gregoryvanko/SemX/STL/assemblage_v13_vue.stl

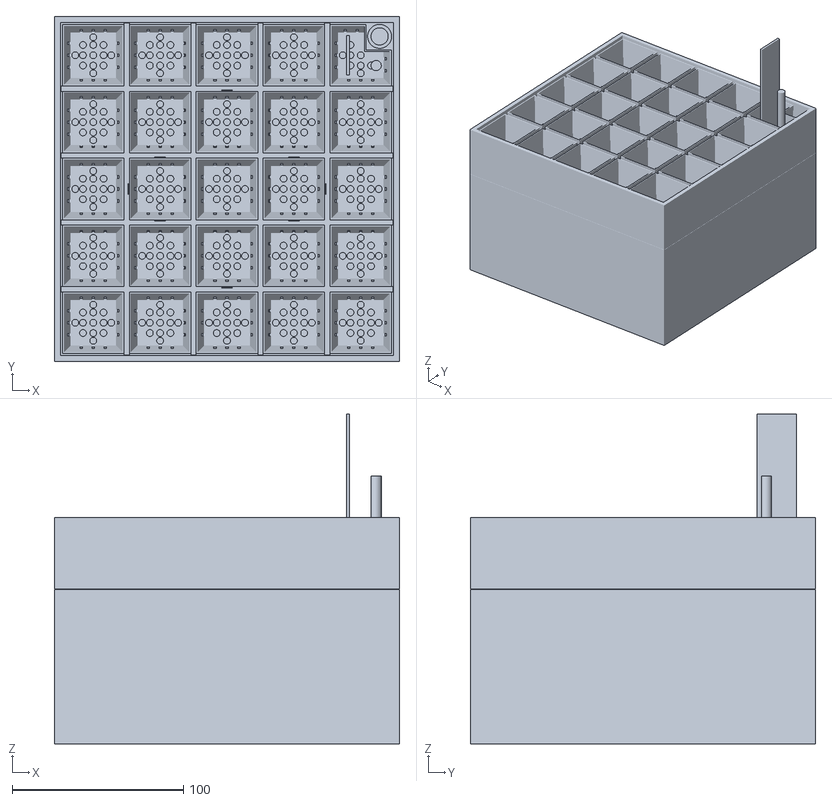
[picture p19: CAD file, 2026-11-14]
STL/assemblage_v13_vue.stl
201.2 x 201.2 x 192.2
