gregoryvanko/SemX/STL/assemblage_v13_eclate_vue.stl

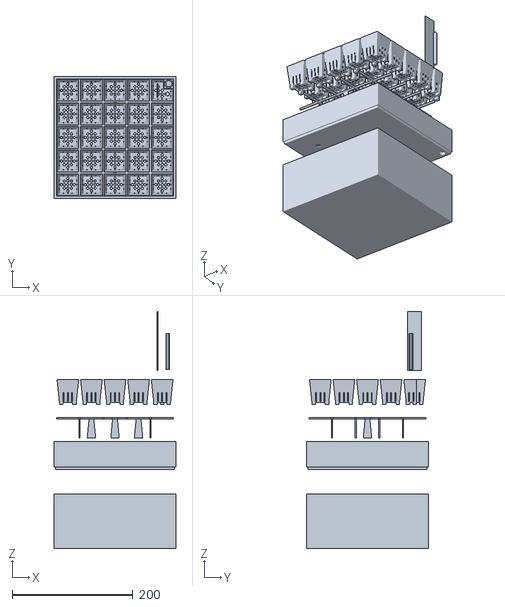
[picture p20: CAD file, 2026-11-14]
STL/assemblage_v13_eclate_vue.stl
201.2 x 201.2 x 392.2
