gregoryvanko/SemX/STL/assemblage_support_led_vue.stl

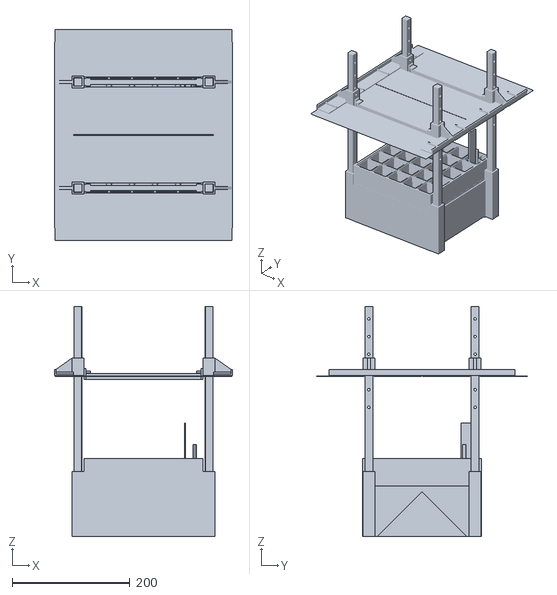
[picture p21: CAD file, 2026-11-14]
STL/assemblage_support_led_vue.stl
302.0 x 357.1 x 390.0
