gregoryvanko/SemX/STL/grille_godets_pieds_193x193x2.stl

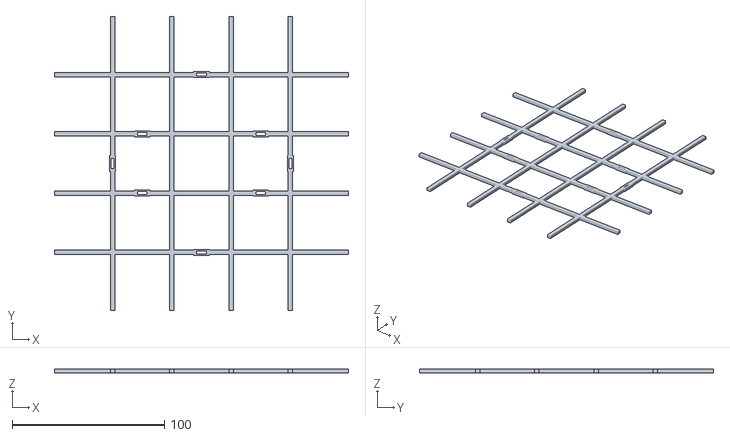
[picture p22: CAD file, 2026-11-14]
STL/grille_godets_pieds_193x193x2.stl
193.4 x 193.4 x 2.40
