gregoryvanko/SemX/STL/godet_mesure_L_36x36x42.stl

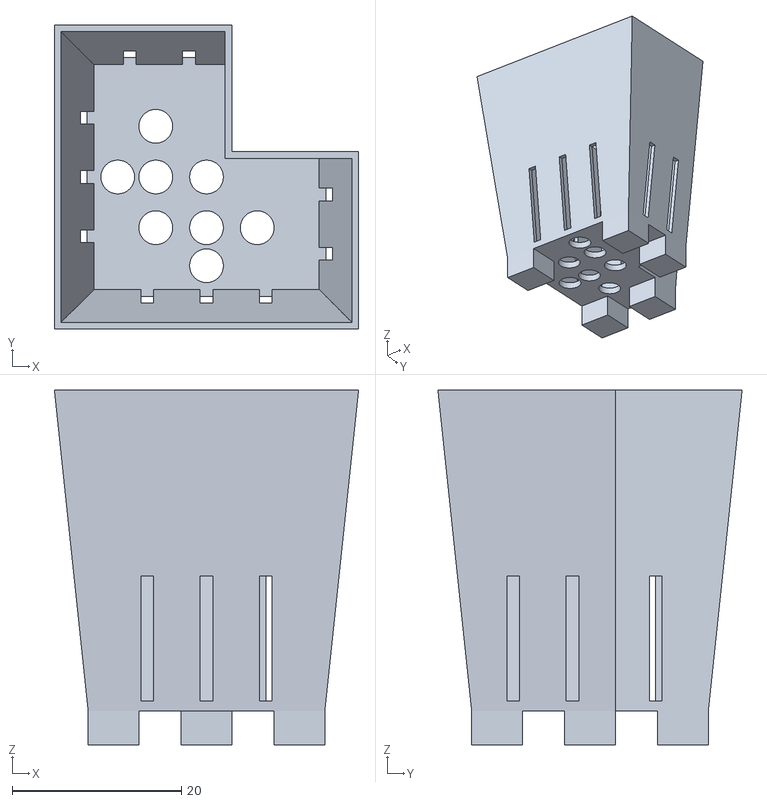
[picture p23: CAD file, 2026-11-14]
STL/godet_mesure_L_36x36x42.stl
36.0 x 36.0 x 42.0
