gregoryvanko/SemX/STL/Electronique couvercle.stl

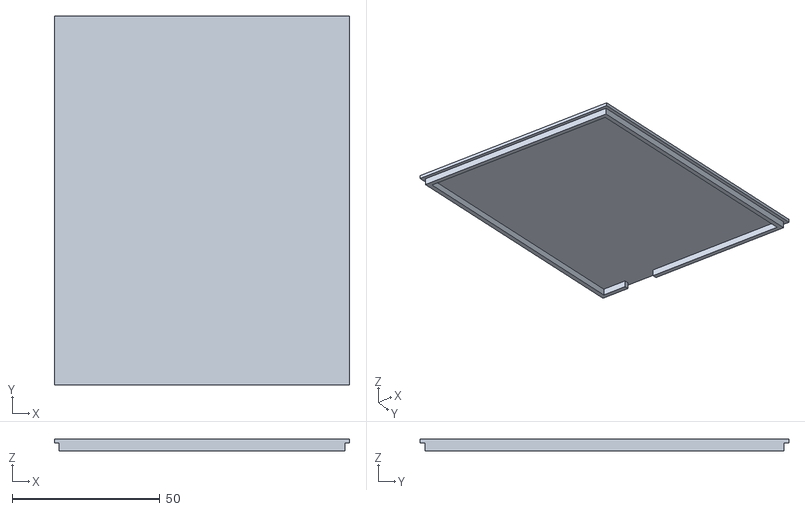
[picture p24: CAD file, 2026-11-09]
STL/Electronique couvercle.stl
100.0 x 125.0 x 4.20
