gregoryvanko/SemX/STL/Electronique boitier.stl

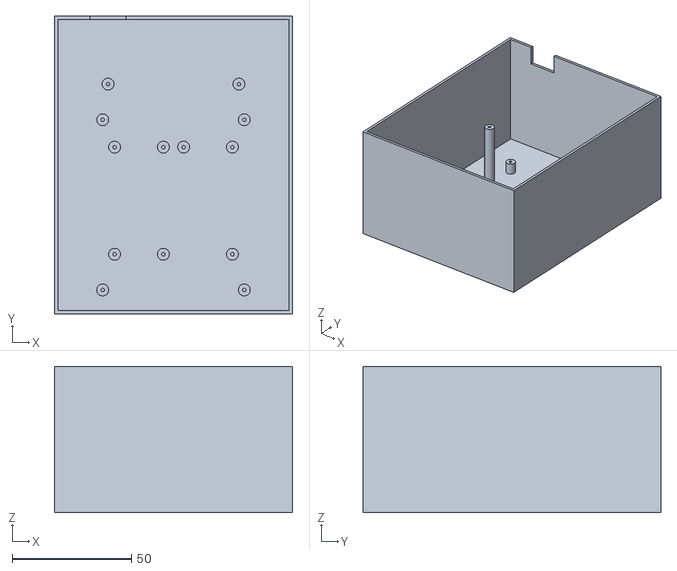
[picture p25: CAD file, 2026-11-09]
STL/Electronique boitier.stl
100.0 x 125.0 x 61.4
