gregoryvanko/SemX/STL/grille_godets_pied_14x33.stl

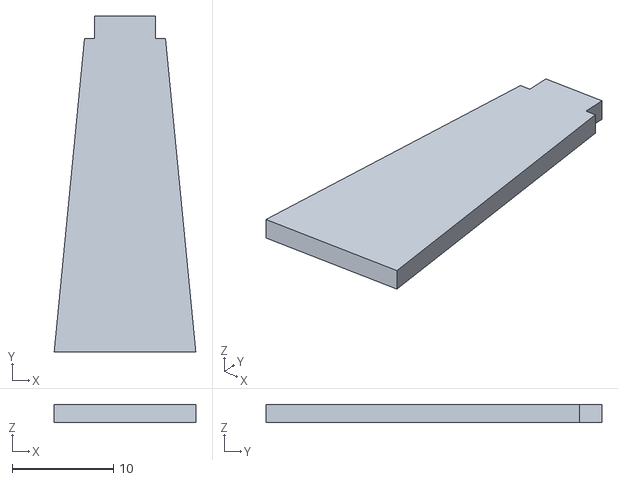
[picture p26: CAD file, 2026-11-08]
STL/grille_godets_pied_14x33.stl
14.0 x 33.2 x 1.80
