gregoryvanko/SemX/STL/support_led_entretoise.stl

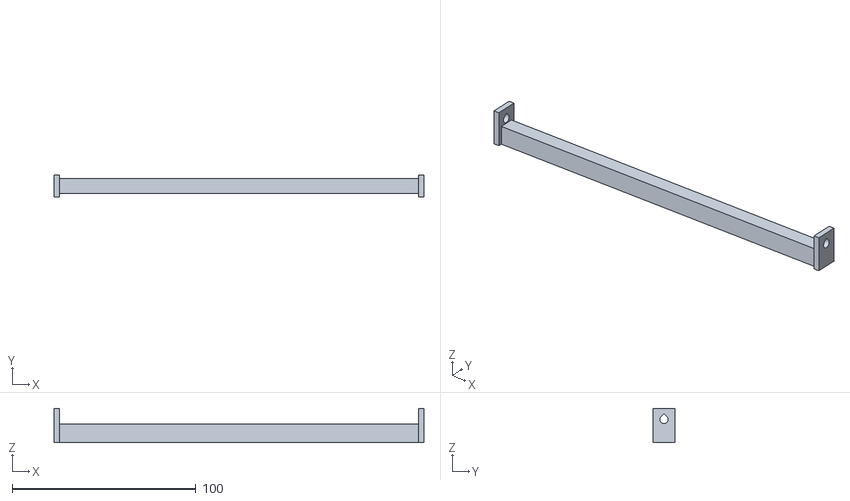
[picture p27: CAD file, 2026-11-05]
STL/support_led_entretoise.stl
201.4 x 12.0 x 18.6
