gregoryvanko/SemX/STL/support_led_traverse.stl

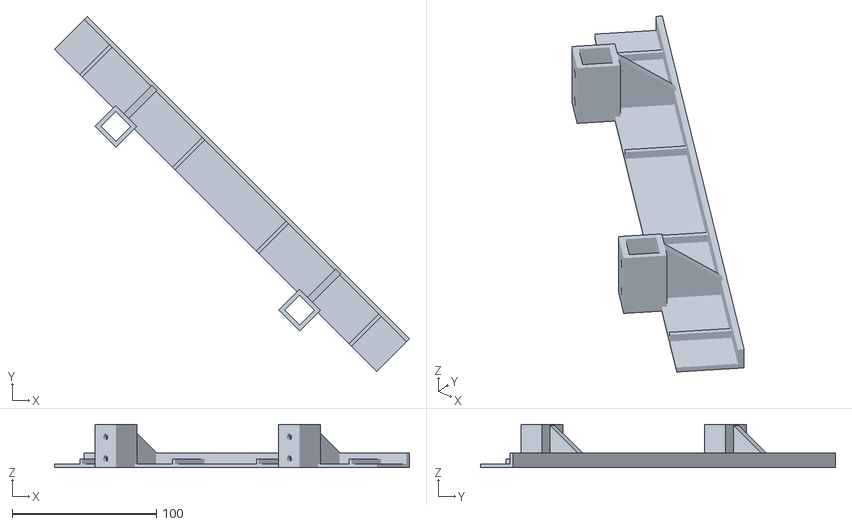
[picture p28: CAD file, 2026-11-01]
STL/support_led_traverse.stl
246.1 x 246.1 x 30.0
