gregoryvanko/SemX/STL/support_led_pied.stl

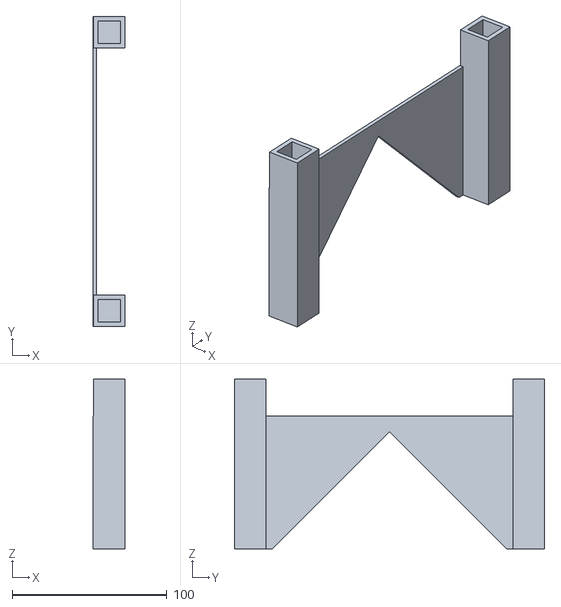
[picture p29: CAD file, 2026-11-01]
STL/support_led_pied.stl
20.9 x 200.6 x 110.0
