gregoryvanko/SemX/STL/support_led_goupille.stl

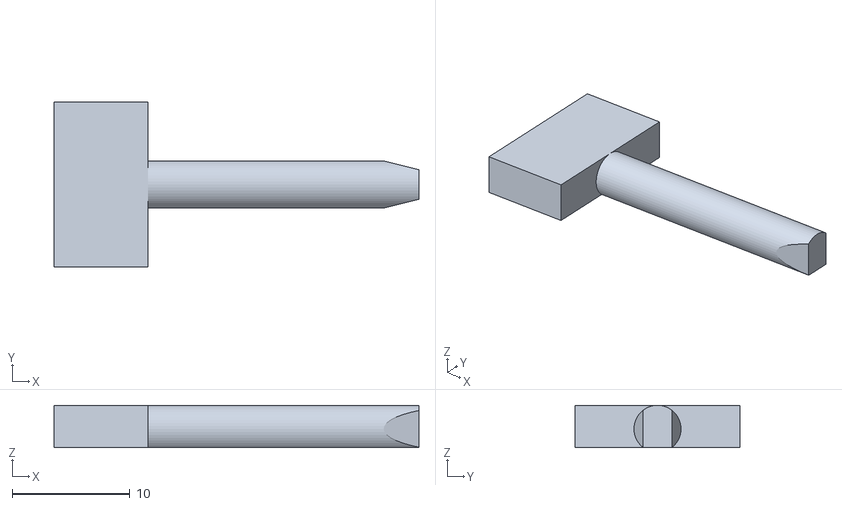
[picture p30: CAD file, 2026-11-01]
STL/support_led_goupille.stl
31.0 x 14.0 x 3.60
