gregoryvanko/SemX/STL/support_led_colonne.stl

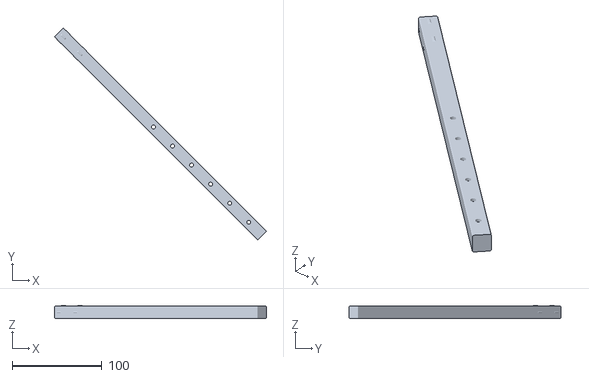
[picture p31: CAD file, 2026-11-01]
STL/support_led_colonne.stl
236.2 x 236.2 x 14.6
