gregoryvanko/SemX/STL/Tuyau Pompe.stl

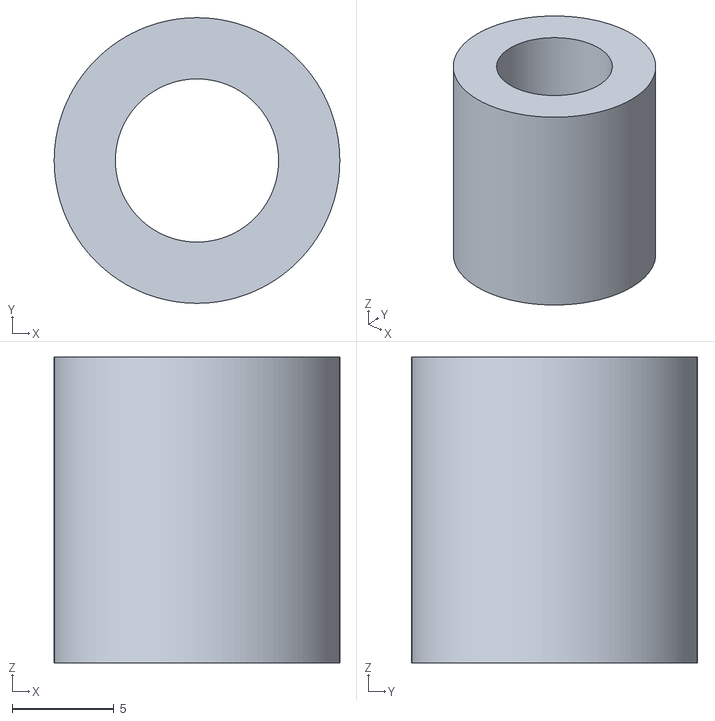
[picture p32: CAD file, 2026-10-24]
STL/Tuyau Pompe.stl
14.0 x 14.0 x 15.0
