gregoryvanko/SemX/STL/reservoir_201x201x90_2piliers_paroi2.0.stl

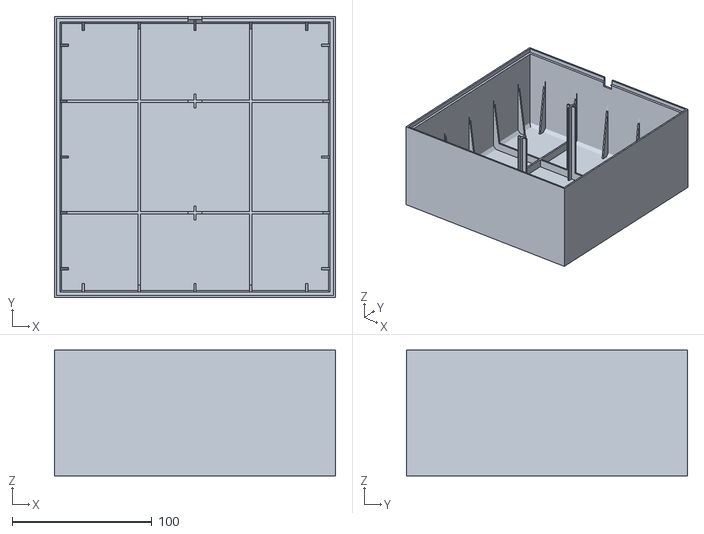
[picture p33: CAD file, 2026-10-24]
STL/reservoir_201x201x90_2piliers_paroi2.0.stl
201.2 x 201.2 x 90.0
