gregoryvanko/SemX/STL/bac_semis_201x201x46_socle.stl

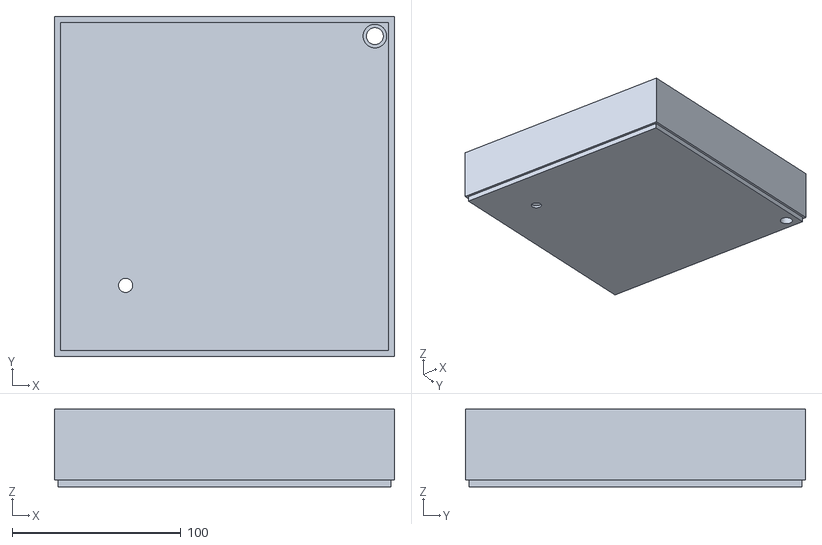
[picture p34: CAD file, 2026-10-24]
STL/bac_semis_201x201x46_socle.stl
201.2 x 201.2 x 46.0
