gregoryvanko/SemX/(list of files, cad)

Other CAD files:
STL/godet_semis_36x36x42.stl
