gregoryvanko/SemX/(commit log)

2026-10-14 README : ajout des éléments techniques (ESP32, capteurs, relais)
2026-10-14 README : ajout du tableau de brochage de l'ESP32
2026-10-23 Ajout de la librairie ESPConnect
    Portail captif WiFi, stockage NVS, reconnexion automatique, bouton de
    réinitialisation, page /status avec configuration MQTT à chaud
    (mqtt/mqtts/ws/wss, TLS sans vérification), statut online/LWT, routes
    web personnalisées et WebSocket. Exemple d'utilisation dans main.cpp.
2026-10-23 ESPConnect : lecture NVS sans erreur pour les clés absentes
    Preferences::getString() journalise « nvs_get_str len fail » quand la
    clé n'existe pas encore ; on vérifie sa présence avec isKey() avant
    de la lire.
2026-10-23 ESPConnect : journal série en ASCII
    Les caractères UTF-8 multi-octets (accents, « », —, …) s'affichaient
    en "???????" dans le moniteur série. Les messages sont désormais
    convertis en ASCII avant l'écriture.
2026-10-23 Exemple : suppression de la publication MQTT semix/uptime
    Seul l'envoi WebSocket de démonstration vers /semis est conservé.
2026-10-23 ESPConnect : mise à jour du firmware par le réseau (OTA)
    enableOTA(motDePasse, port) active ArduinoOTA dès la connexion WiFi.
    MQTT et WebSockets sont fermés proprement au début du téléversement,
    MQTT est relancé en cas d'échec. État OTA affiché sur /status,
    progression et erreurs dans le journal série.
2026-10-23 initiation du setup de l'application
2026-10-24 nouveau couvercle godet
    [couvercle_godet_mesure_36x19.stl]
2026-10-25 update couvercle
    [couvercle_godet_mesure_36x19.stl]
2026-10-27 page de commande web SemW
2026-10-31 relay controleur default value
2026-10-31 support de godet mesure
    [support_godet_mesure_36x19.stl]
2026-11-01 support panneaux led
    [assemblage_support_led_vue.stl, support_led_colonne.stl, support_led_goupille.stl, support_led_pied.stl, support_led_traverse.stl]
2026-11-01 support LED à quatre colonnes et rendus 3D
    Remplace les deux colonnes par quatre colonnes de 14 mm pour que chaque
    face forme un portique et résiste à la torsion. Un pied à deux fûts par
    face garantit l'écartement des colonnes, et une traverse à deux
    coulisseaux porte les panneaux, dont les deux centraux sont maintenant
    jointifs au-dessus du bac.
    Ajoute le script de rendu et les images 3D intégrées au README.
    [assemblage_support_led_vue.stl, support_led_colonne.stl, support_led_goupille.stl, support_led_pied.stl, support_led_traverse.stl]
2026-11-01 traverses collées, entretoises et nervures de colonne
    Les panneaux de 1 mm sont maintenant collés sous les traverses par leur
    face arrière, avec huit adhésifs 3M de 30 × 50 mm posés sur des plages
    planes. Les poches sont supprimées et le dessous des panneaux reste libre
    pour les fiches USB-C. Les trous du coulisseau sont décalés pour garder
    la marge au-dessus du capteur d'humidité.
    Ajoute deux entretoises fixées par les goupilles, rallongées de 3 mm, et
    des nervures d'écrasement en bas de colonne pour supprimer le jeu dans le
    pied, avec une pièce de test pour régler le serrage.
    [assemblage_support_led_vue.stl, support_led_colonne.stl, support_led_entretoise.stl, support_led_goupille.stl, support_led_test_nervures.stl, support_led_traverse.stl]
2026-11-01 retire la pièce de test des nervures
    Le serrage de 0,1 mm est validé sur une pièce imprimée : la pièce de test
    n'est plus utile. La colonne reste inchangée.
    [support_led_test_nervures.stl]
2026-11-01 ramène les pieds dans la largeur du réservoir
    Le pied dépassait de 2,2 mm de chaque côté. Il fait maintenant 200,6 mm
    pour un réservoir de 201,2 mm : l'entraxe des colonnes passe à 180,1 mm
    et les panneaux sont resserrés d'autant, seule la colonne passant entre
    eux. Pied et traverse changent, les autres pièces restent identiques.
    [assemblage_support_led_vue.stl, support_led_pied.stl, support_led_traverse.stl]
2026-11-01 rigidifie les traverses avec une bande de collage continue
    Remplace les quatre plages séparées par une bande de 32 mm sur toute la
    longueur, qui forme une cornière avec la paroi. La section la plus faible
    devient 2,3 fois plus rigide en flexion verticale pour 4 g de plus par
    traverse. Les autres pièces restent identiques.
    [assemblage_support_led_vue.stl, support_led_traverse.stl]
2026-11-05 entretoise à un seul trou, plus basse, réglage par crans de 30 mm
    [assemblage_support_led_vue.stl, support_led_entretoise.stl]
2026-11-05 entretoise suspendue sous la goupille, entre les panneaux
    [assemblage_support_led_vue.stl, support_led_entretoise.stl]
2026-11-06 PCB de l'ESP32 à graver à la CNC et description des pièces du bac
    Ajoute un circuit simple face pour l'ESP32 DevKit C V4, les sondes, les
    relais et le bornier 5 V, avec une diode qui permet de garder l'USB branché.
    Le script PCB/pcb_semix.py génère Gerber, perçage et G-code GRBL.
    Ajoute au README les rendus et la description du réservoir, du bac, des
    godets et de leurs accessoires, générés par CAD/rendu_pieces.py.
    [SemiX-B_Cu.gbl, SemiX-Edge_Cuts.gm1, SemiX.drl]
2026-11-07 relais led
2026-11-08 grille sur pieds pour empêcher les godets de basculer
    Grille mince à mi-hauteur des godets, tenue par 8 pieds plats emboîtés,
    imprimée en 33 min. Variante posée sur le bord du bac, qui empêche aussi
    les godets de flotter.
    [grille_godets_haute_201x206x6.stl, grille_godets_pied_14x33.stl, grille_godets_pieds_193x193x2.stl]
2026-11-08 supprime la variante de grille posée sur le bord du bac
    [grille_godets_haute_201x206x6.stl]
2026-11-09 boîtier de l'électronique et son couvercle, avec rendus dans le README
    [Electronique boitier.stl, Electronique couvercle.stl]
2026-11-10 godets plus ouverts pour que l'eau humidifie le terreau plus vite
    13 trous de 4 mm au fond au lieu de 9 de 3 mm, et 3 fentes de 1,5 mm
    au bas de chaque paroi, sous le niveau du trop-plein. Dimensions
    inchangées. Script CAD/godets.py, rendus et README mis à jour.
    [godet_mesure_36x19x42.stl, godet_semis_36x36x42.stl]
2026-11-11 page web : voyants d'état en vert plus clair et bouton de reset dans un accordéon Reset
    [config_page.h]
2026-11-11 supprime la section licence du README
2026-11-11 mode humidité : la pompe ne démarre que sous le seuil bas, même après un redémarrage
2026-11-11 MQTT : état et mode de la pompe et de l'éclairage publiés à chaque mesure
2026-11-14 godet de mesure en L autour du trop-plein, sans support ni couvercle
    Le godet de mesure prend l'emprise d'un godet de semis, échancré en L autour du
    trop-plein : il tient dans la grille et le support n'est plus nécessaire. Les
    capteurs se plantent directement dans le terreau. Vues d'assemblage v13 générées
    par CAD/assemblage.py, images et README mis à jour.
    [assemblage_support_led_vue.stl, assemblage_v12_eclate_vue.stl, assemblage_v12_vue.stl, assemblage_v13_eclate_vue.stl, assemblage_v13_vue.stl, couvercle_godet_mesure_36x19.stl, godet_mesure_36x19x42.stl, godet_mesure_L_36x36x42.stl]
